growbox-DIY/external-monitor/case/case_body.stl

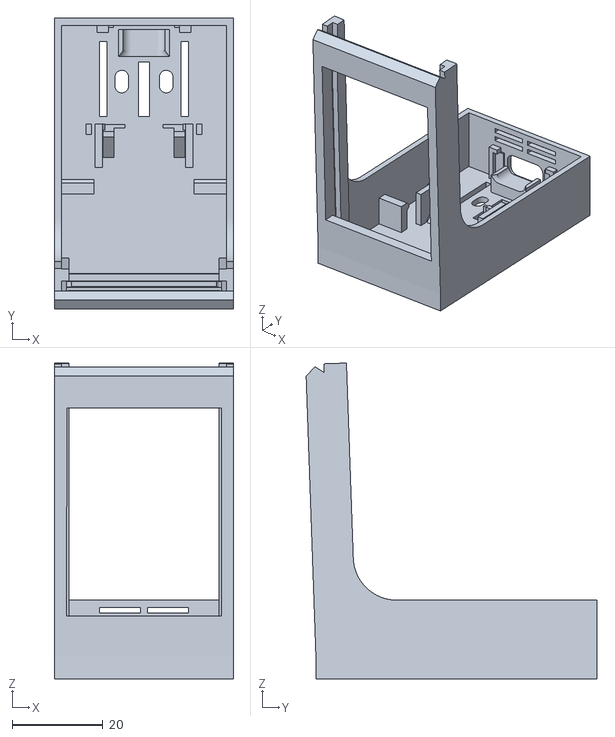
[picture p4: CAD file, 2026-10-30]
case/case_body.stl
39.6 x 64.2 x 69.7
