growbox-DIY/external-monitor/case/screen.stl

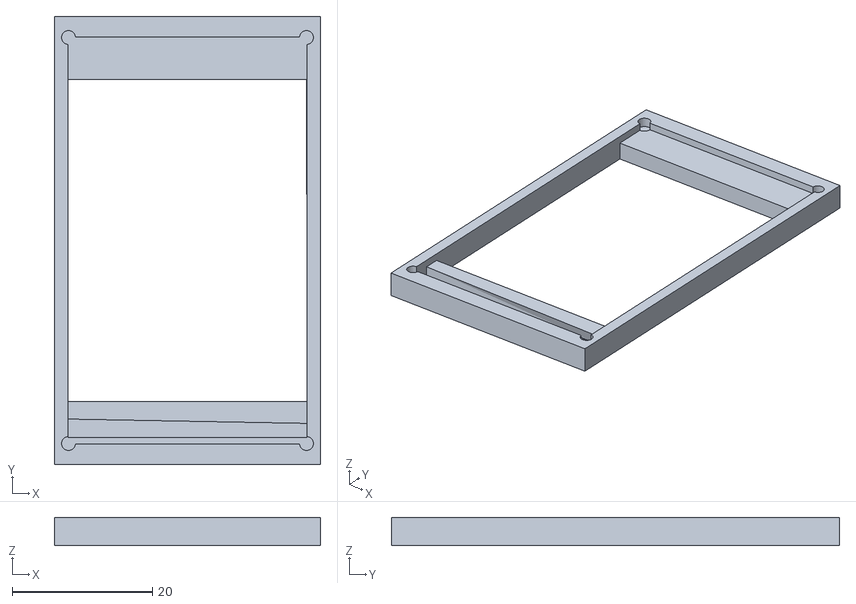
[picture p5: CAD file, 2026-10-30]
case/screen.stl
38.0 x 64.0 x 4.00
