growbox-DIY/external-monitor/case/case_roof.stl

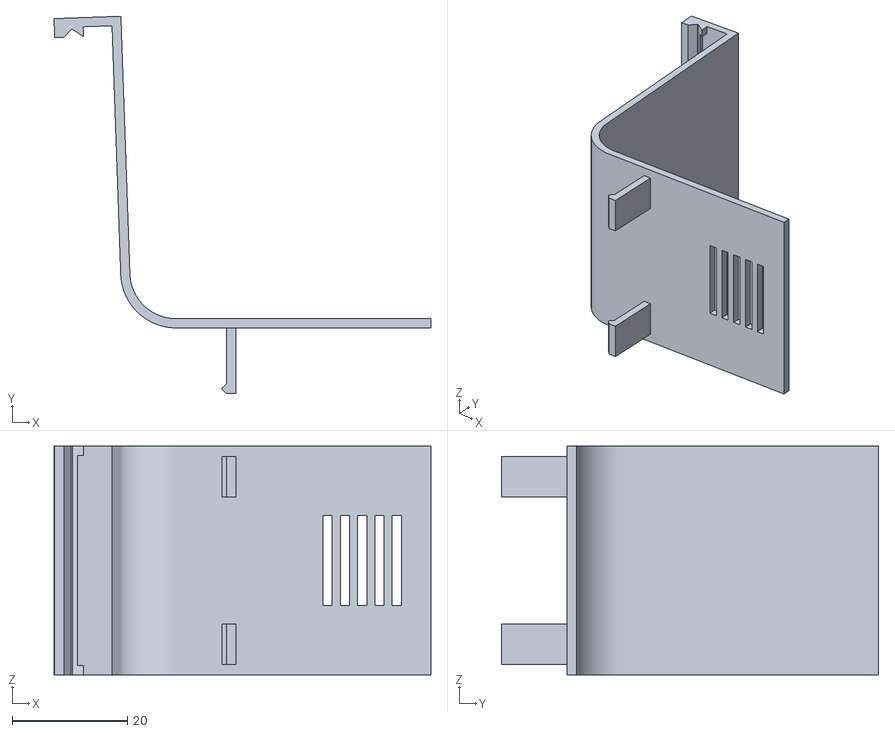
[picture p6: CAD file, 2026-10-30]
case/case_roof.stl
65.3 x 65.4 x 39.6
