growbox-DIY/external-monitor/case/front_plate.stl

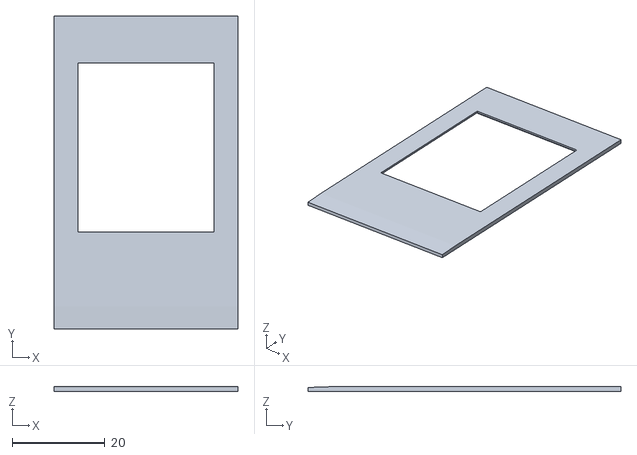
[picture p7: CAD file, 2026-10-30]
case/front_plate.stl
39.6 x 67.5 x 1.00
