growbox-DIY/external-monitor/src/secrets_example.py

# Copy as secrets.py (not committed to git) and fill in.
SSID = "your-network"
PASSWORD = "your-password"

# optionally other networks; default SSID and SSID + "_EXT" (TP-Link extender)
# NETWORKS = (("your-network", "your-password"),
#             ("your-extender", "its-password"))

# API_TOKEN from src/api_token.py of the main ESP
API_TOKEN = "paste-token-here"
